eepyminded/openlab-drone/RAPORT/photo_meas_setup.png

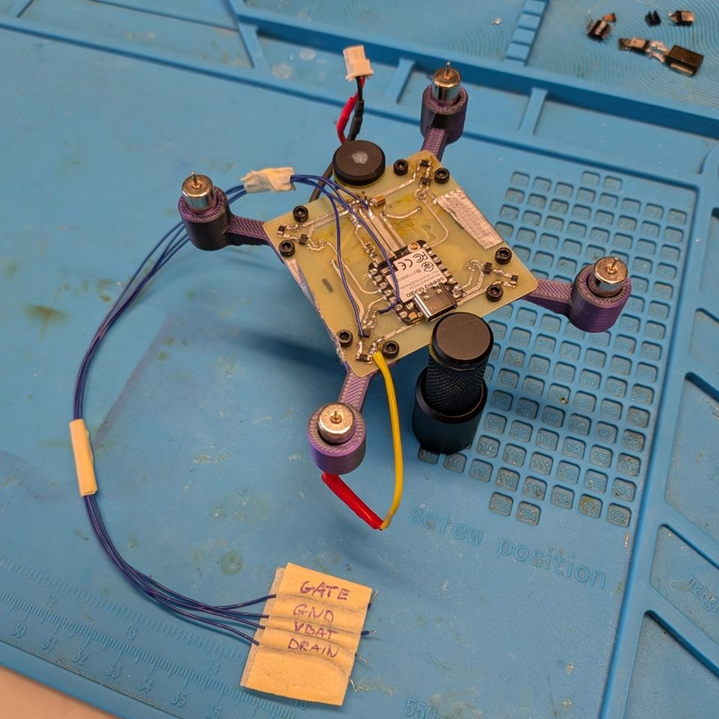
RAPORT/photo_meas_setup.png
