eepyminded/openlab-drone/RAPORT/photo_closeup_soldering.png

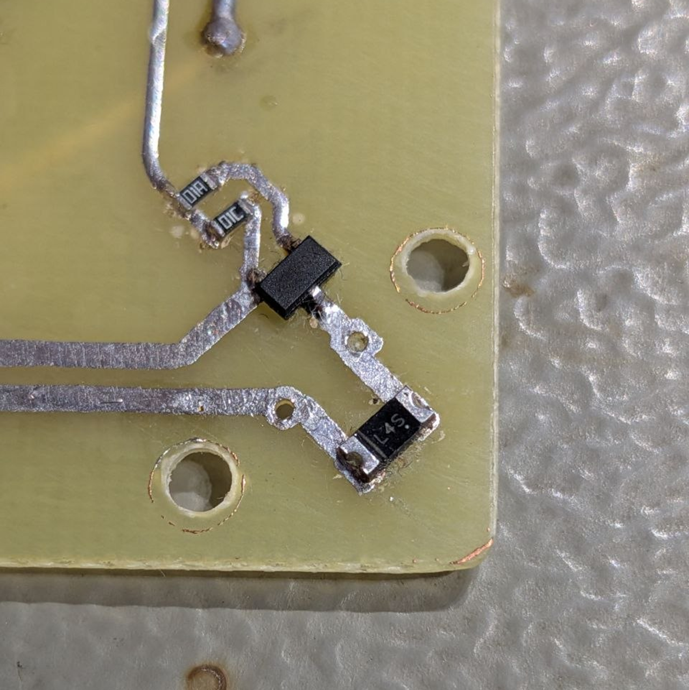
RAPORT/photo_closeup_soldering.png
