eepyminded/openlab-drone/media/Messenger_creation_0ABA836D-BF5E-4B1F-B3B8-3727AC7F190E.jpg

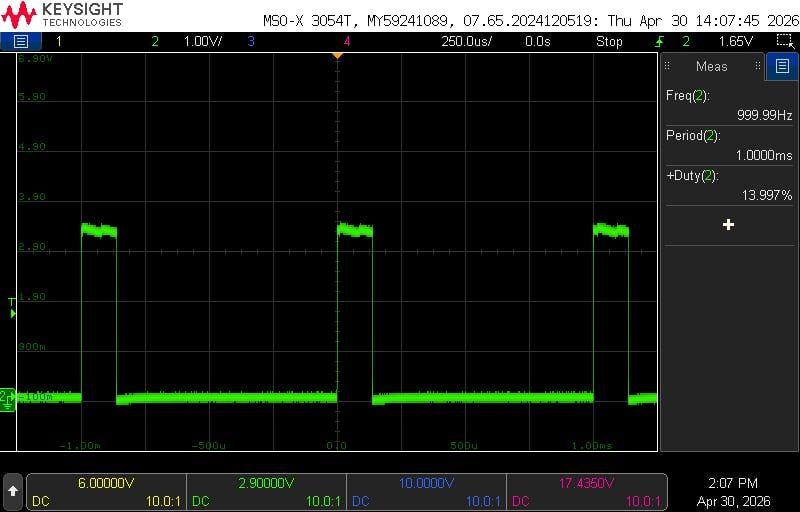
media/Messenger_creation_0ABA836D-BF5E-4B1F-B3B8-3727AC7F190E.jpg
