eepyminded/openlab-drone/media/scope_33.png

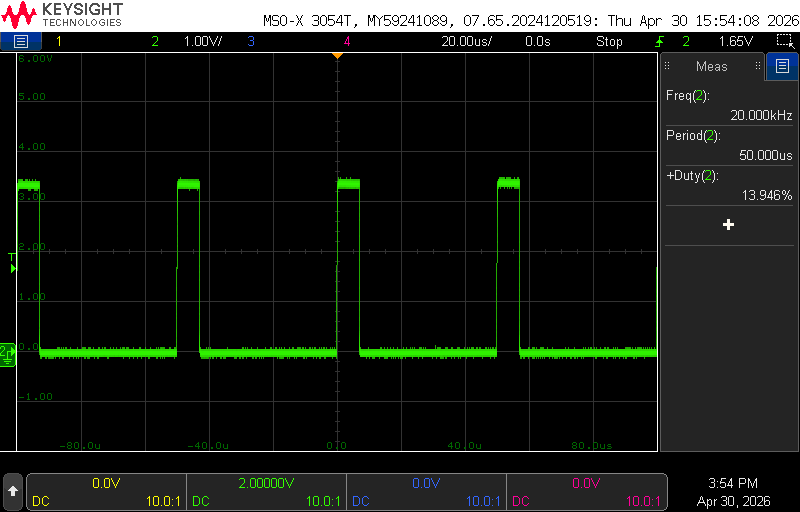
media/scope_33.png
