eepyminded/openlab-drone/media/scope_34.png

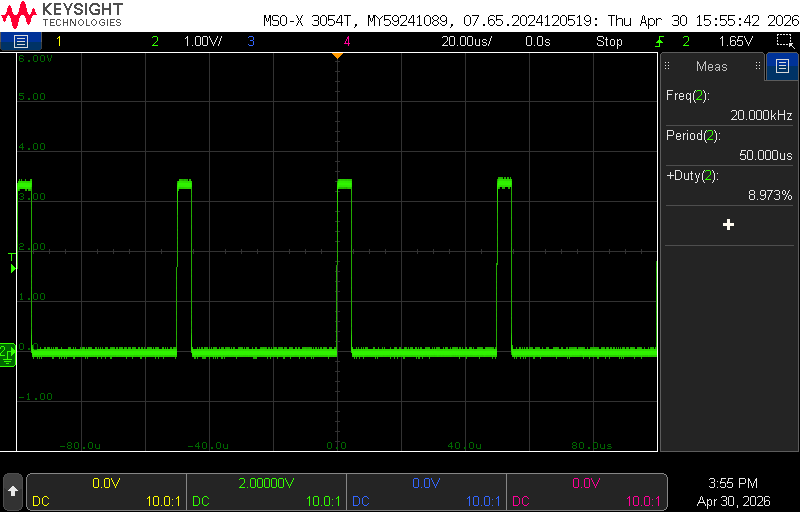
media/scope_34.png
