eepyminded/openlab-drone/media/scope_35.png

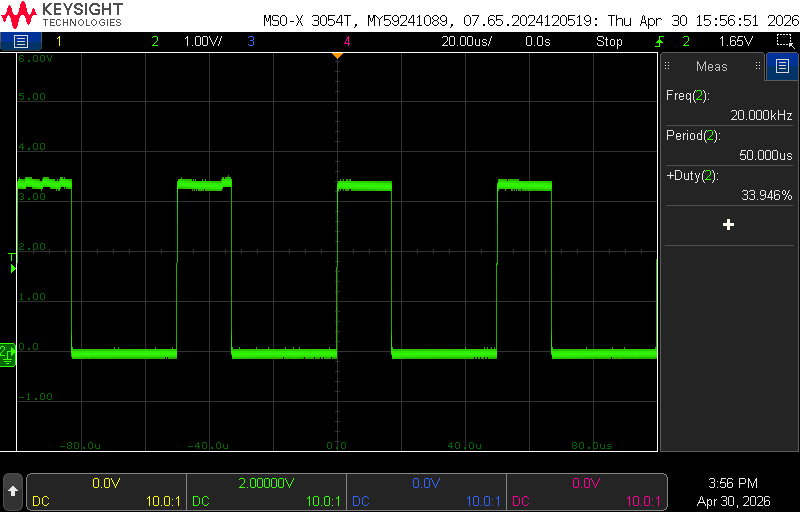
media/scope_35.png
