eepyminded/openlab-drone/RAPORT/meas_20us.png

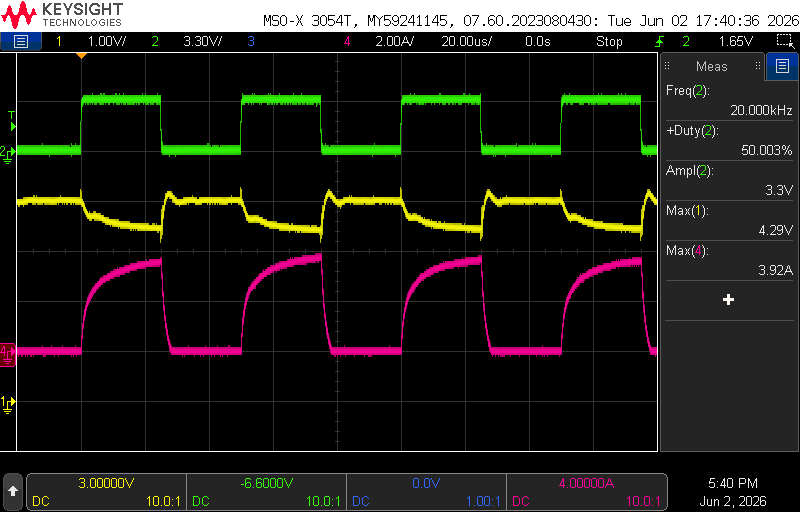
RAPORT/meas_20us.png
