eepyminded/openlab-drone/RAPORT/meas_100ns.png

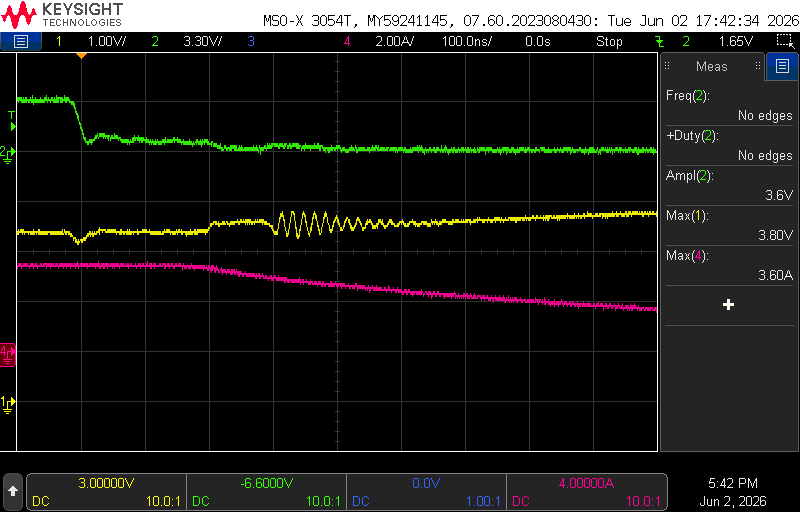
RAPORT/meas_100ns.png
