eepyminded/openlab-drone/RAPORT/meas_100ns_4u7.png

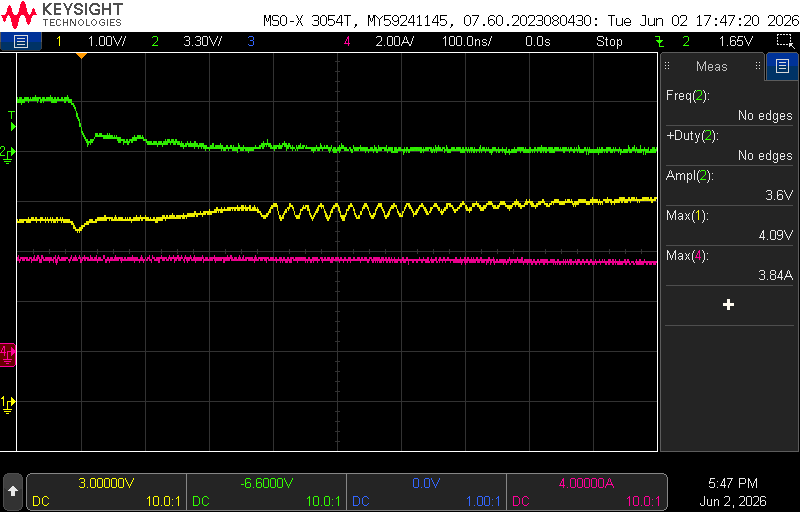
RAPORT/meas_100ns_4u7.png
