eepyminded/openlab-drone/RAPORT/render_drone.png

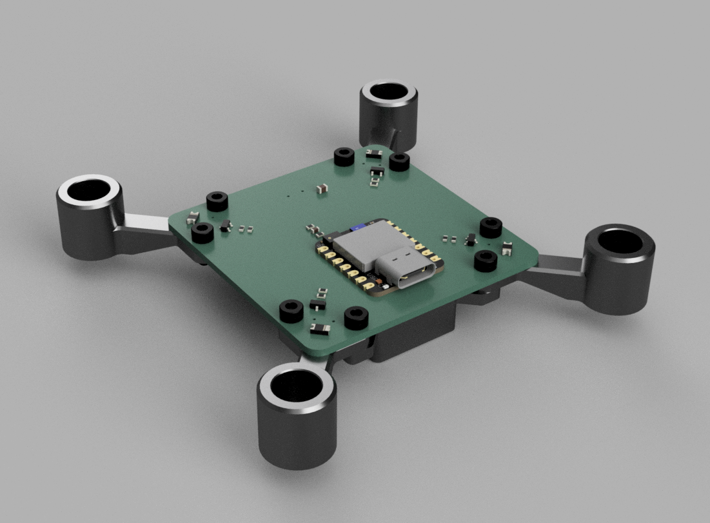
RAPORT/render_drone.png
