eepyminded/openlab-drone/RAPORT/schem_board-1.png

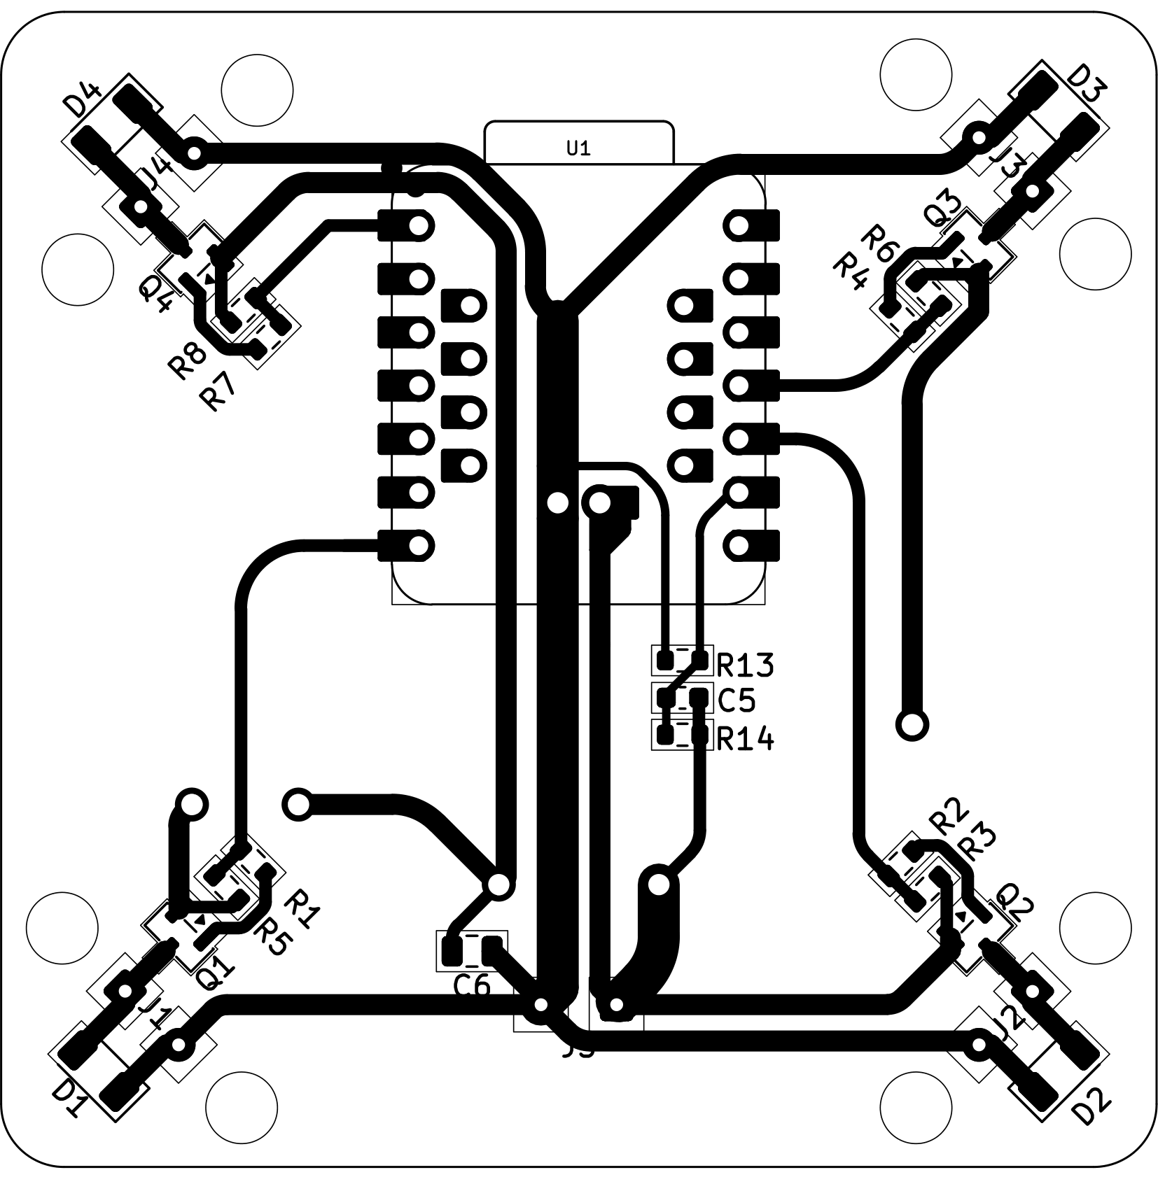
RAPORT/schem_board-1.png
