eepyminded/openlab-drone/RAPORT/schem_pcb-1.png

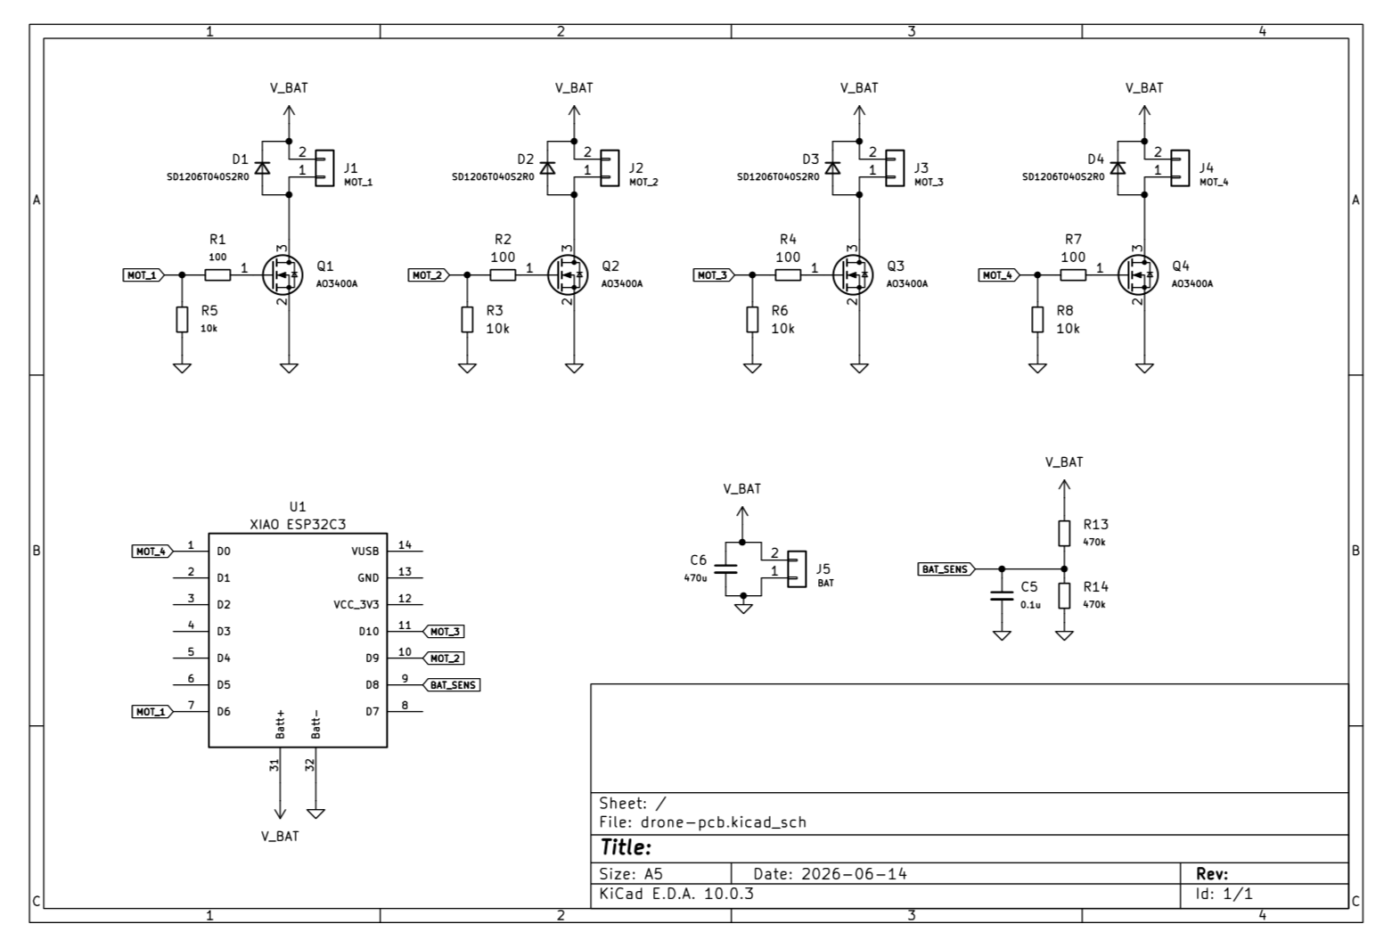
RAPORT/schem_pcb-1.png
