eepyminded/openlab-drone/RAPORT/spice_flyback_diode.png

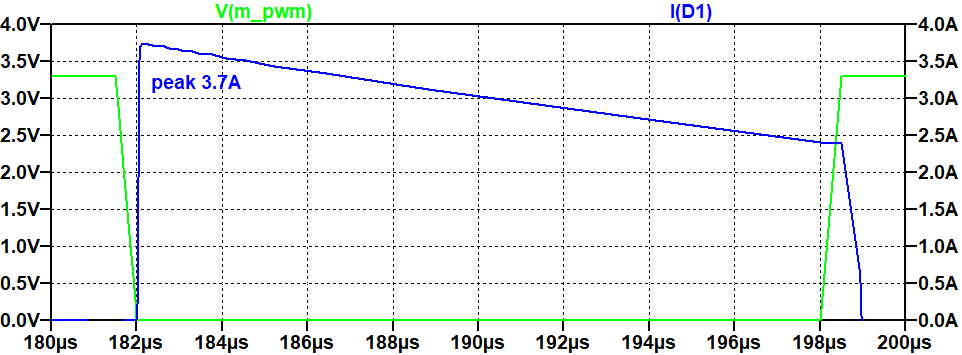
RAPORT/spice_flyback_diode.png
