eepyminded/openlab-drone/RAPORT/spice_r1_current.png

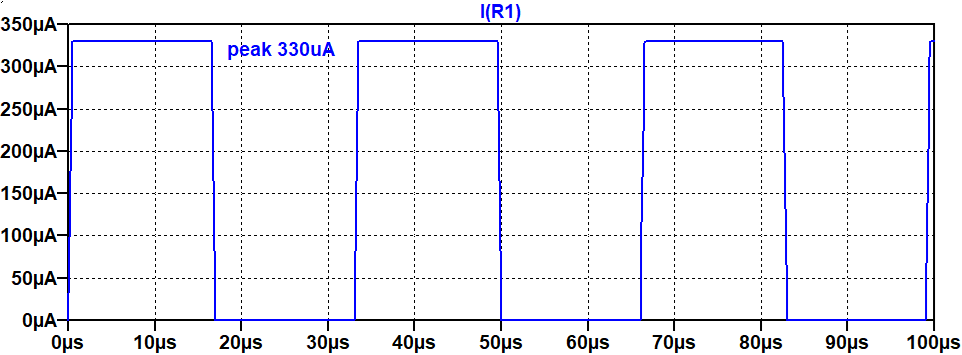
RAPORT/spice_r1_current.png
