eepyminded/openlab-drone/RAPORT/spice_r2_current.png

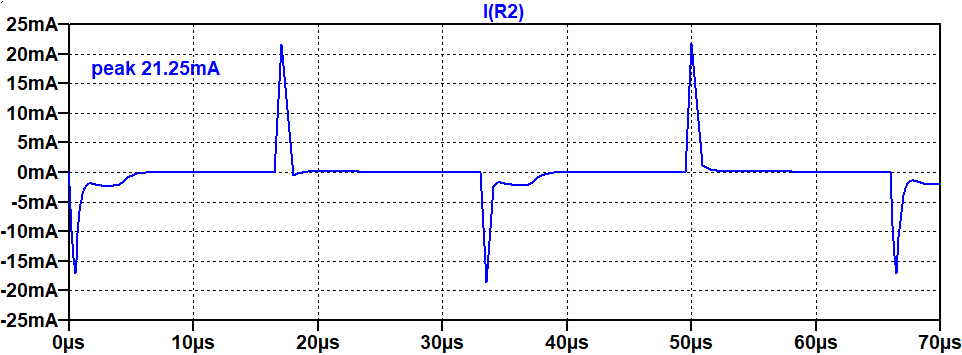
RAPORT/spice_r2_current.png
