eepyminded/openlab-drone/RAPORT/spice_schem.png

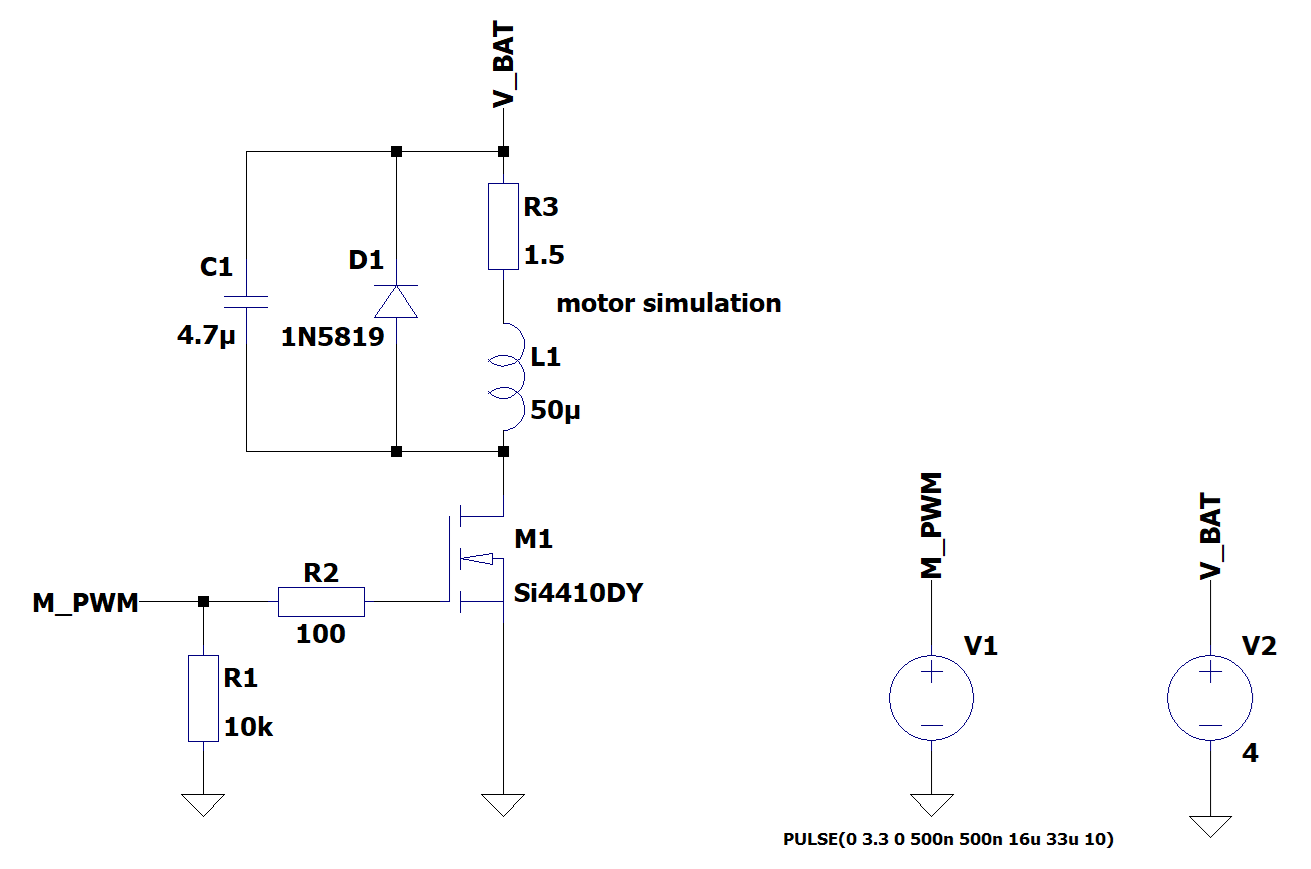
RAPORT/spice_schem.png
