eepyminded/openlab-drone/RAPORT/XIAO_MGM240S_KICAD_Prj-3.png

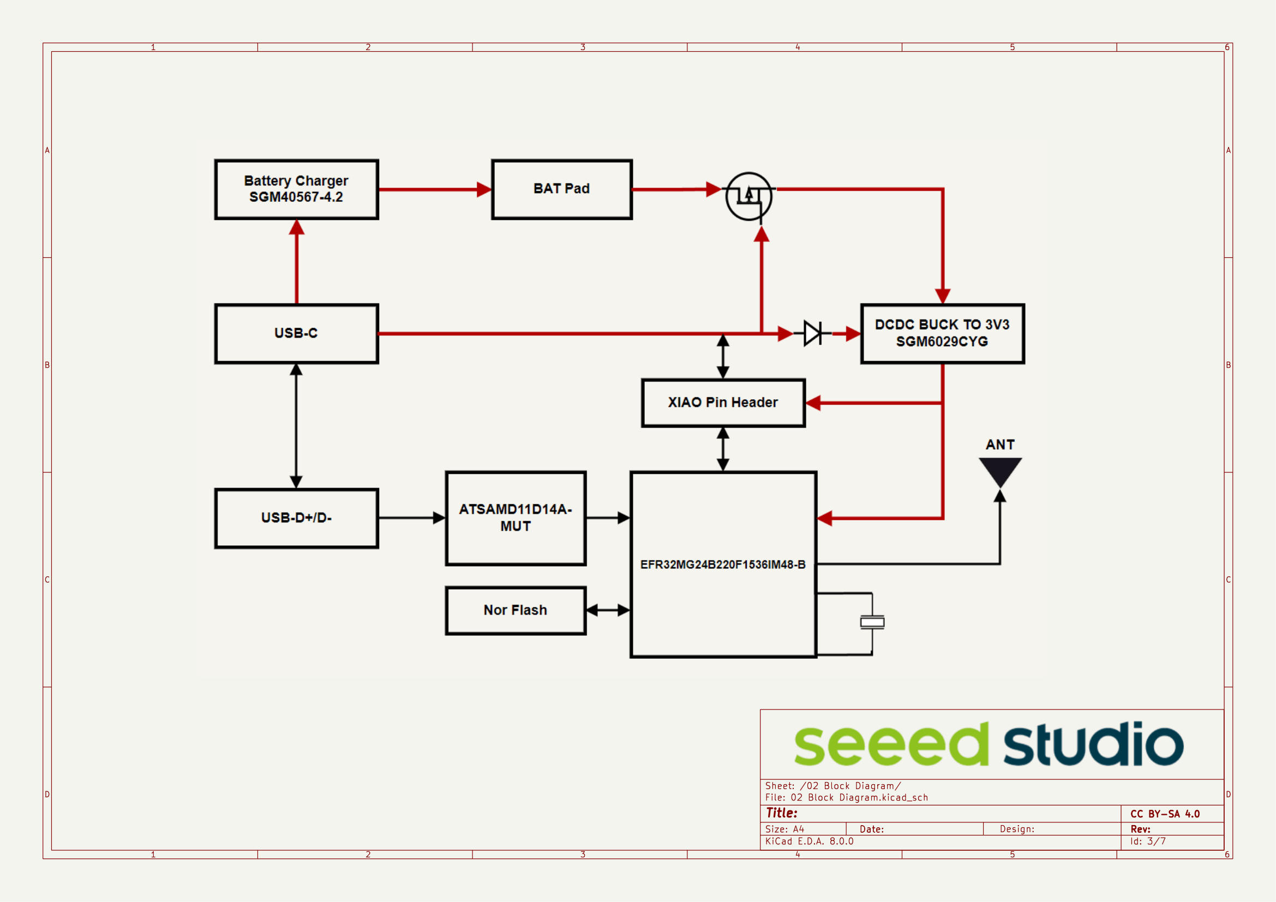
RAPORT/XIAO_MGM240S_KICAD_Prj-3.png
