eepyminded/openlab-drone/(list of files, cad)

Other CAD files:
drone.f3z
