eepyminded/openlab-drone/RAPORT/photo_printed_motor_housing.png

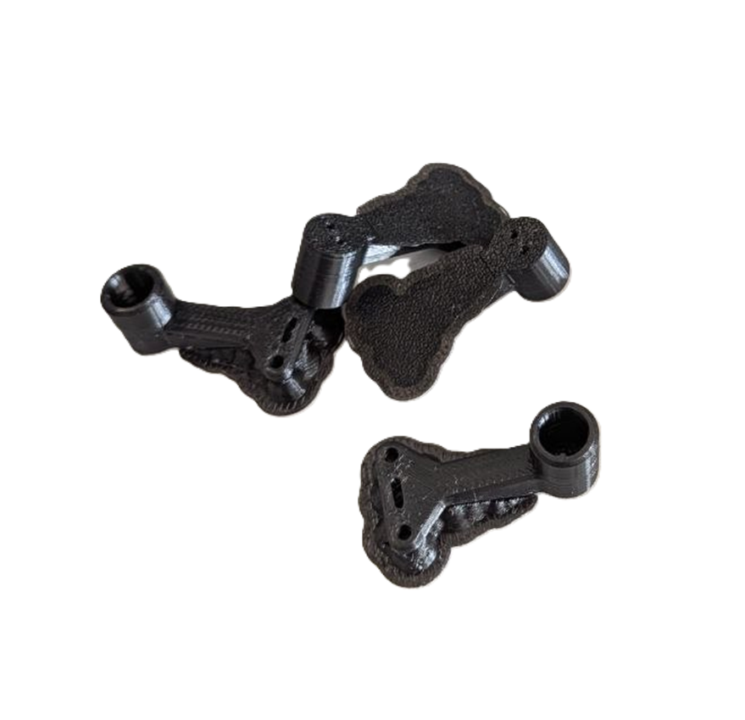
RAPORT/photo_printed_motor_housing.png
