eepyminded/openlab-drone/RAPORT/photo_soldered_pcb.png

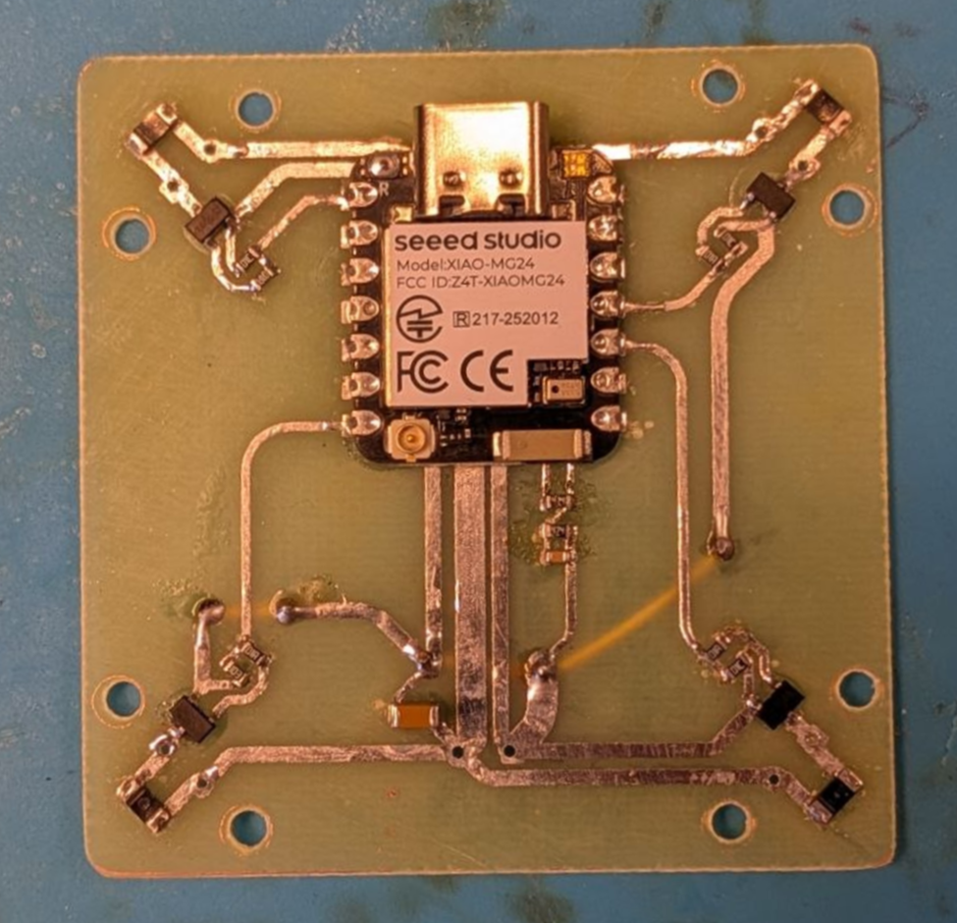
RAPORT/photo_soldered_pcb.png
