eepyminded/openlab-drone/RAPORT/schem_mechanical.pdf

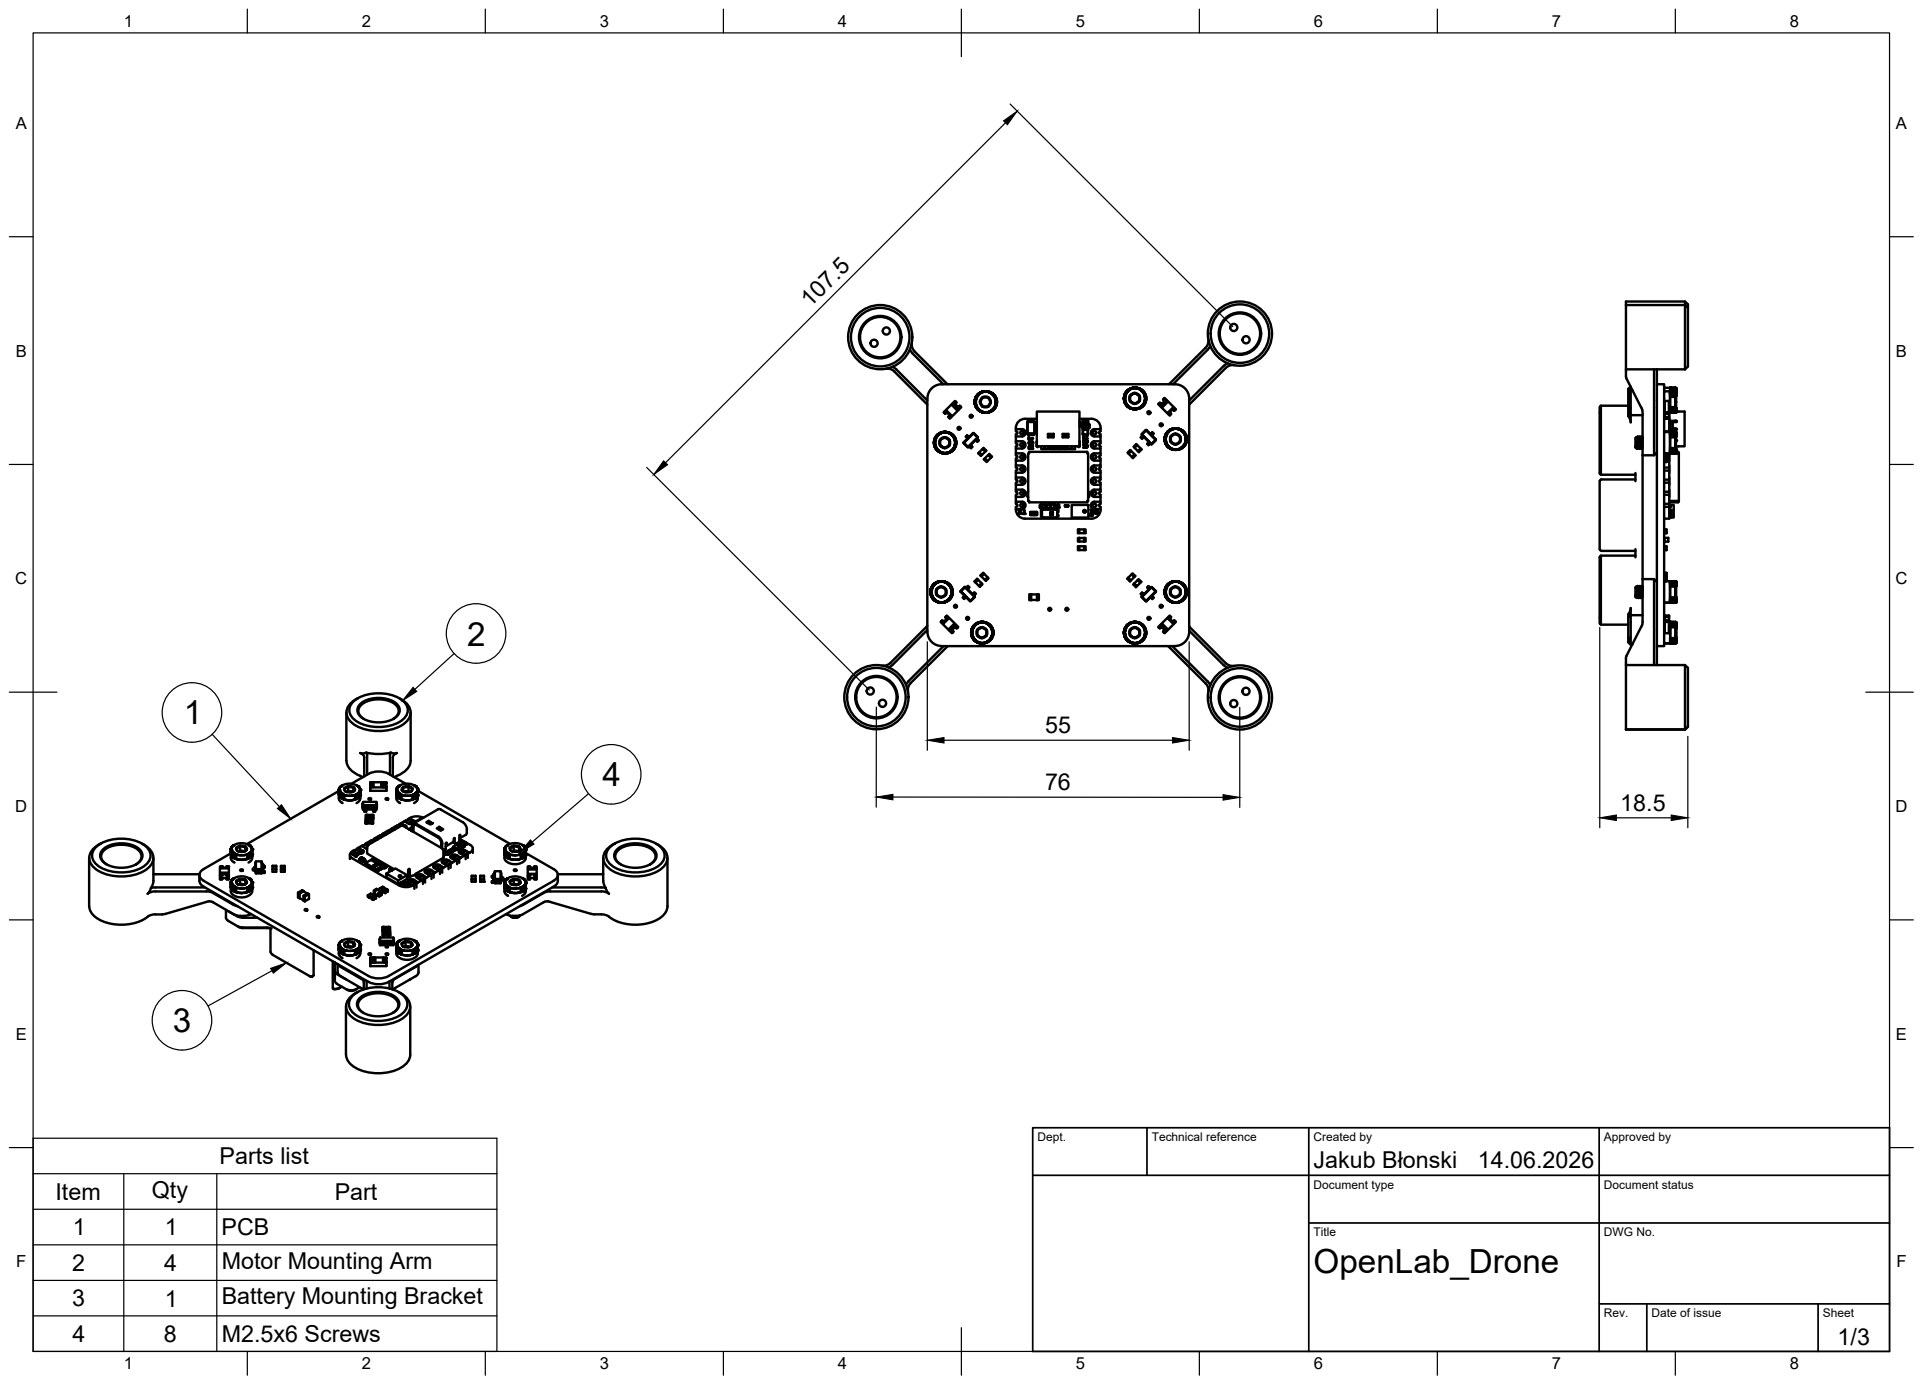
[picture p75: page 1]
Dept.; Technical reference; Created by; Approved by; Document type; Document status; Title; DWG No.; Rev.; Date of issue; Sheet; Jakub Błonski; Parts list; Motor Mounting Arm; Battery Mounting Bracket; M2.5x6 Screws

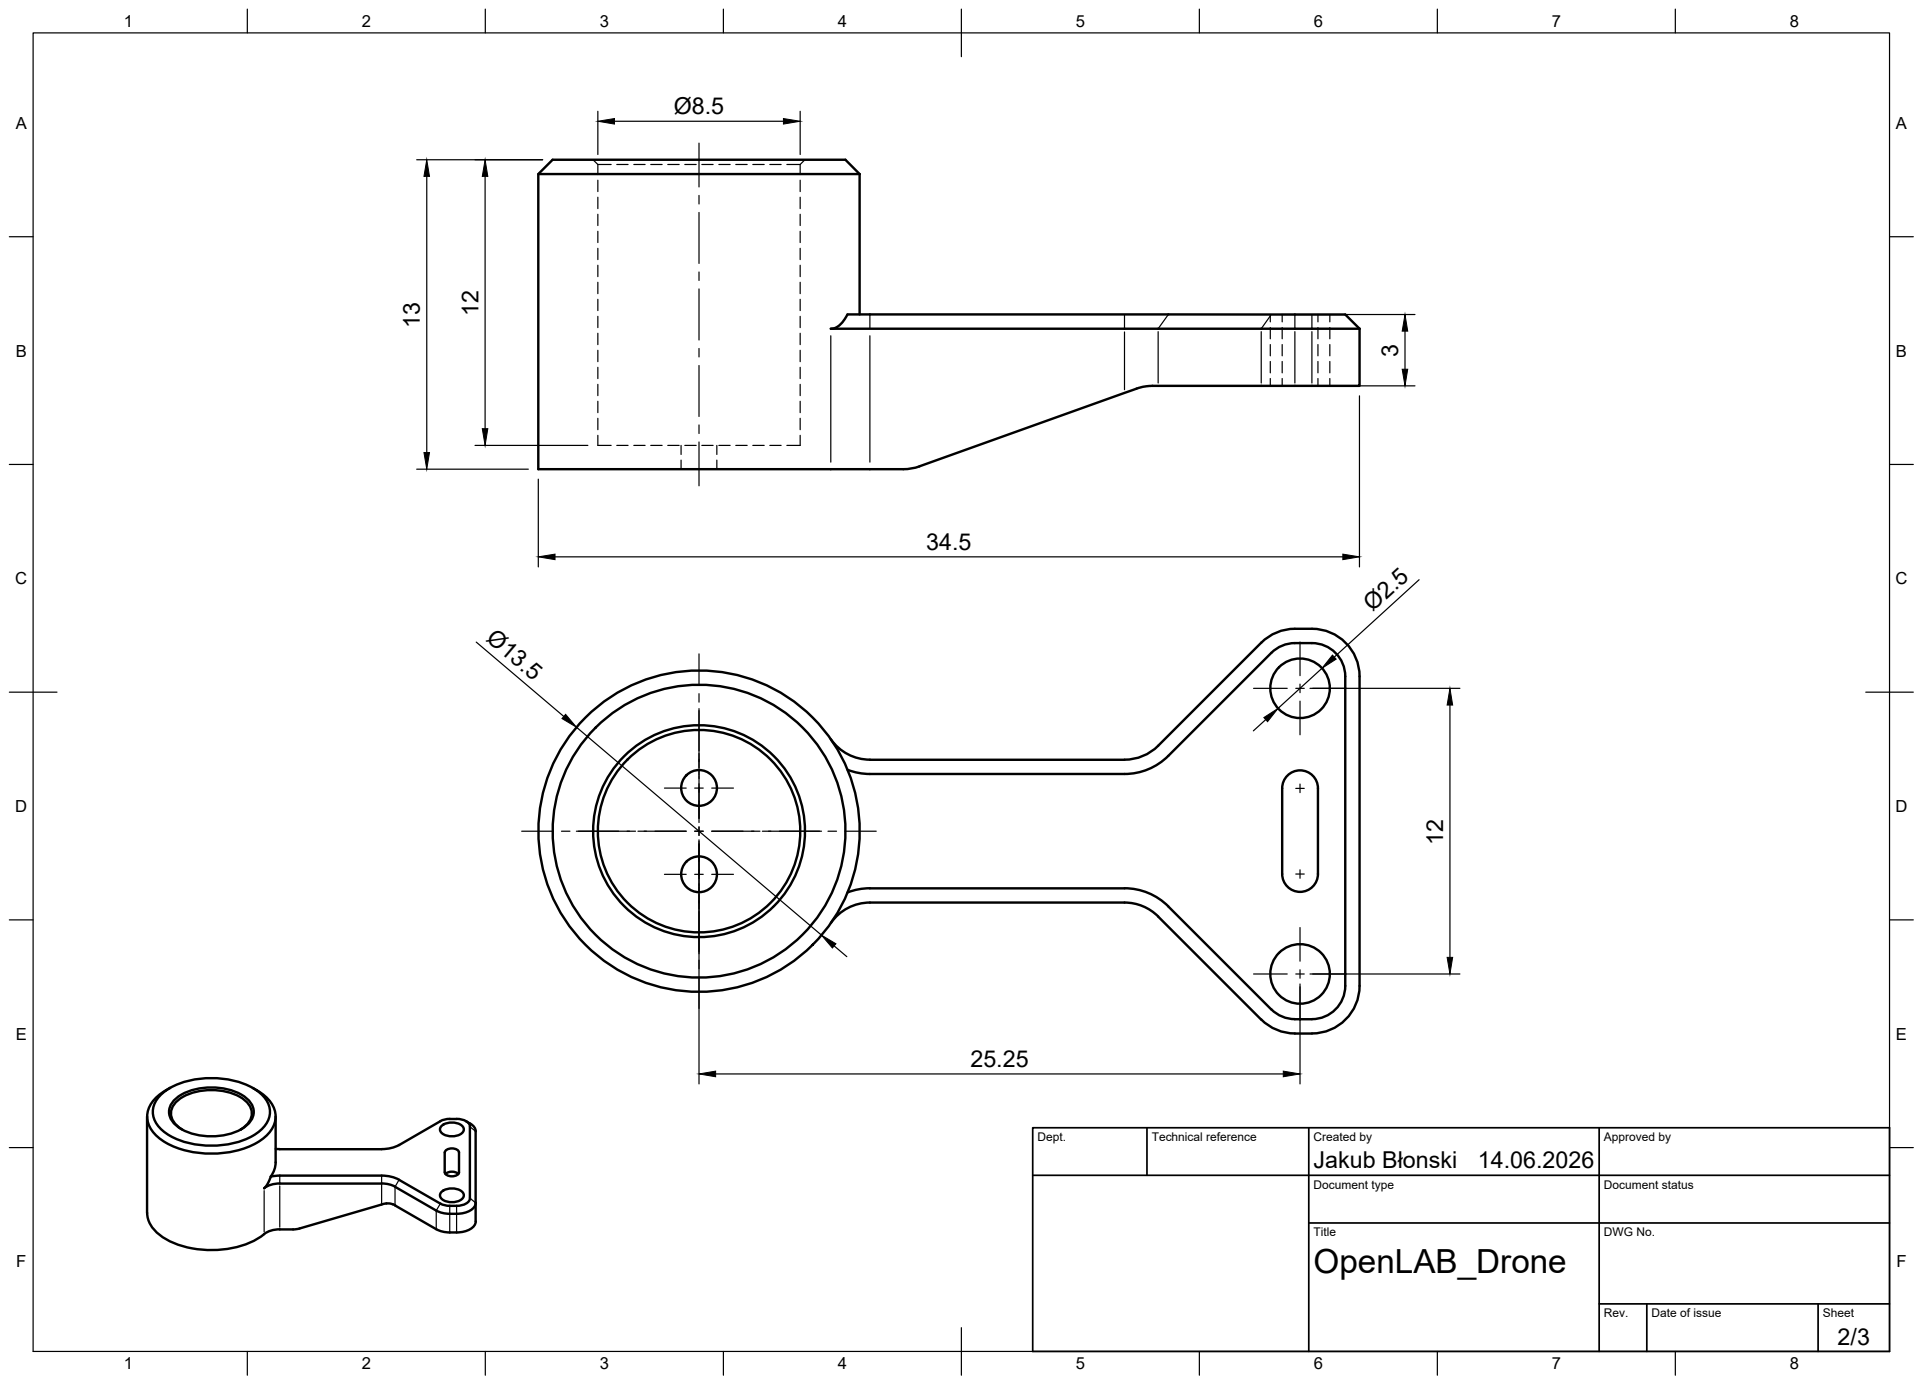
[picture p76: page 2]
Title; DWG No.

Dept. | Technical reference | Created by Jakub Błonski 14.06.2026 | Approved by

Document type | Document status

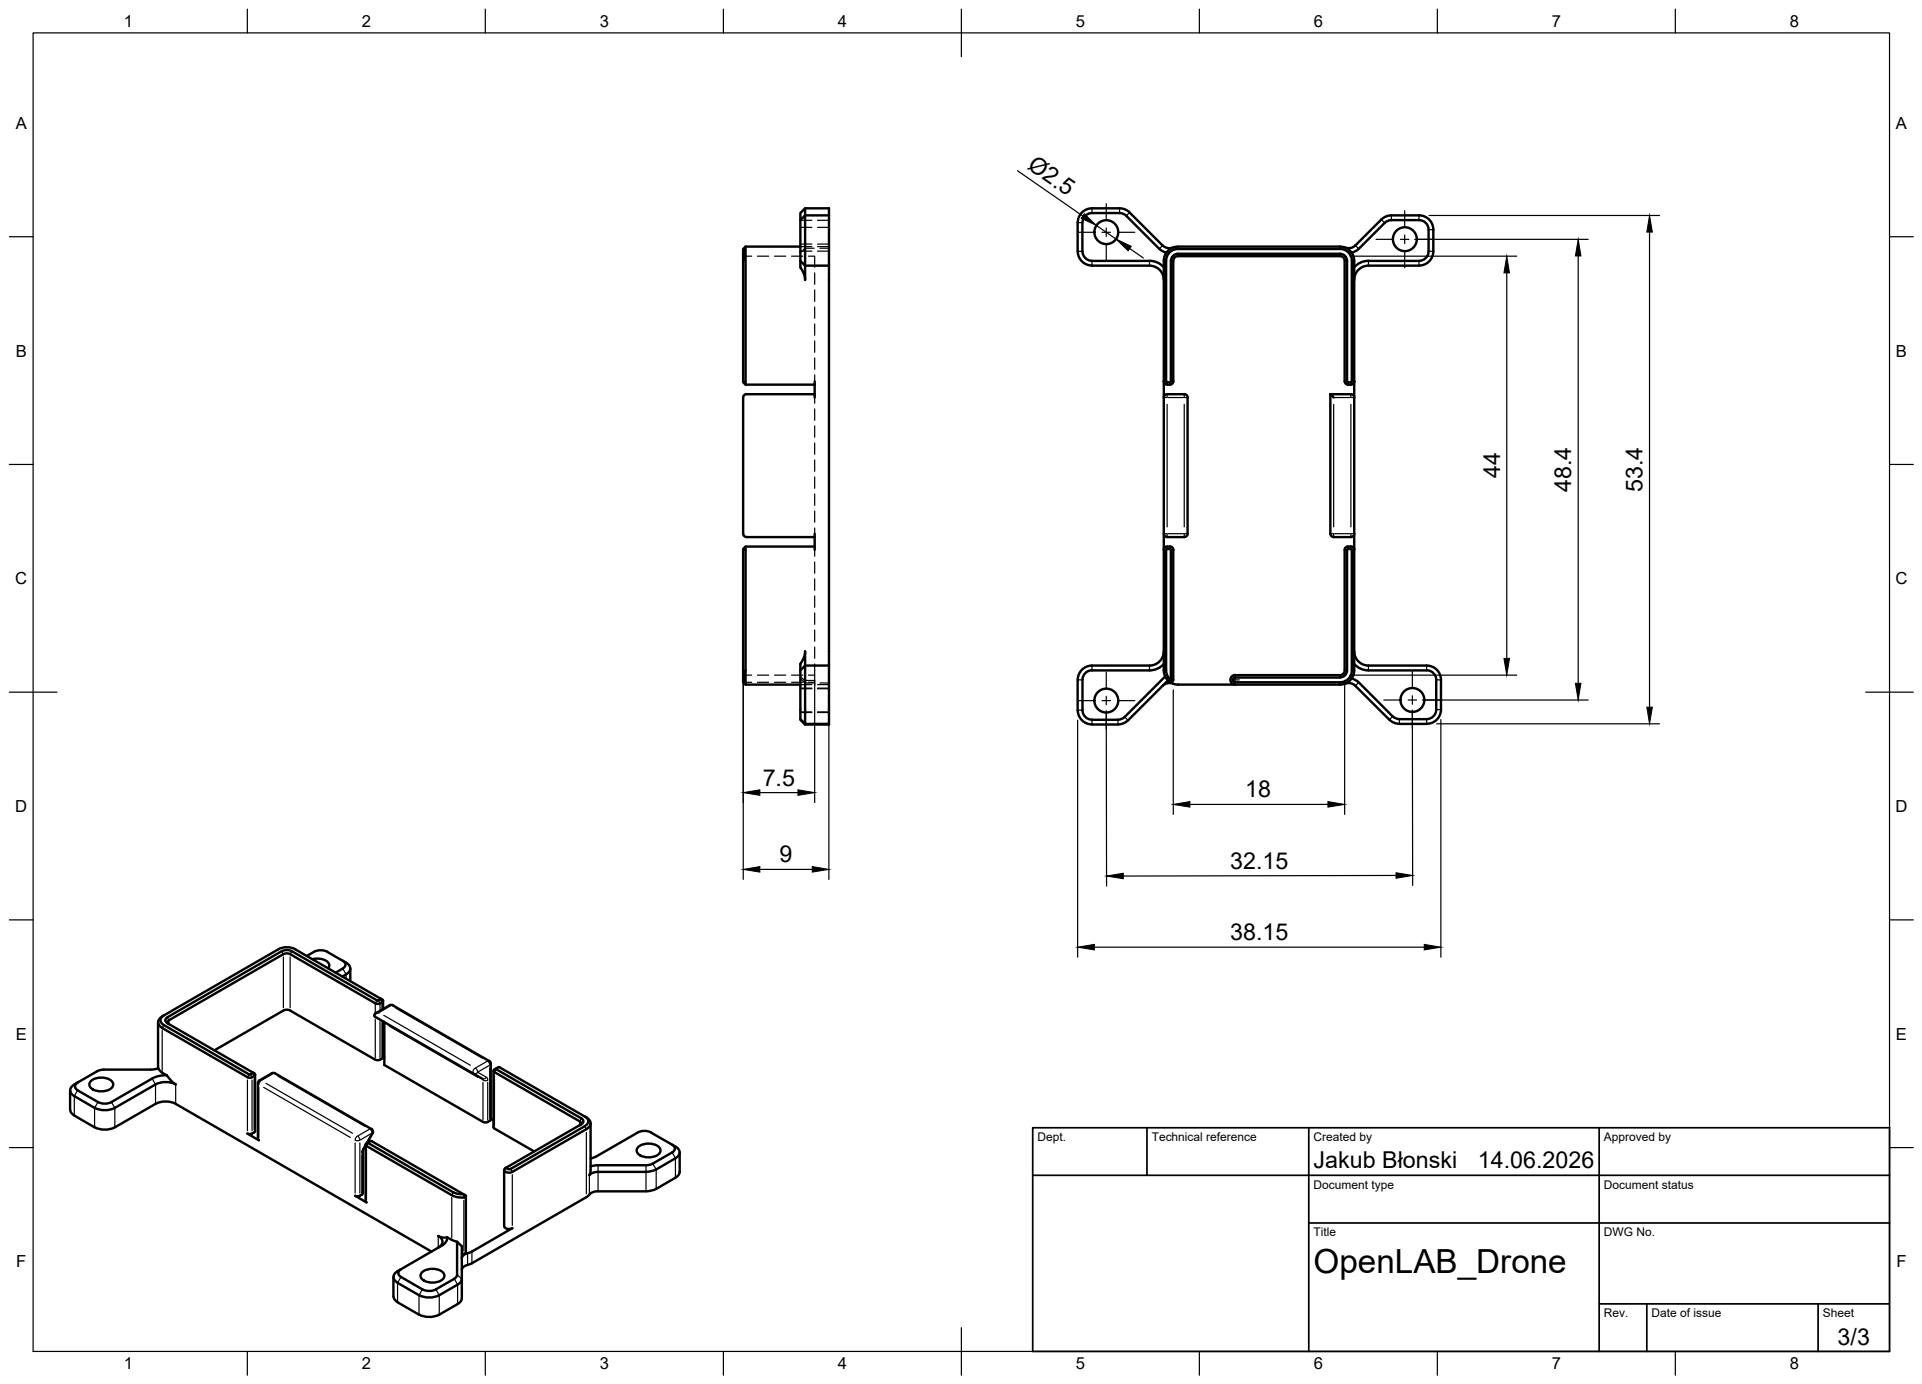
[picture p77: page 3]
Title; DWG No.

Dept. | Technical reference | Created by Jakub Błonski 14.06.2026 | Approved by

Document type | Document status
