eepyminded/openlab-drone/drone-pcb/plots/drone-pcb__Assembly.pdf

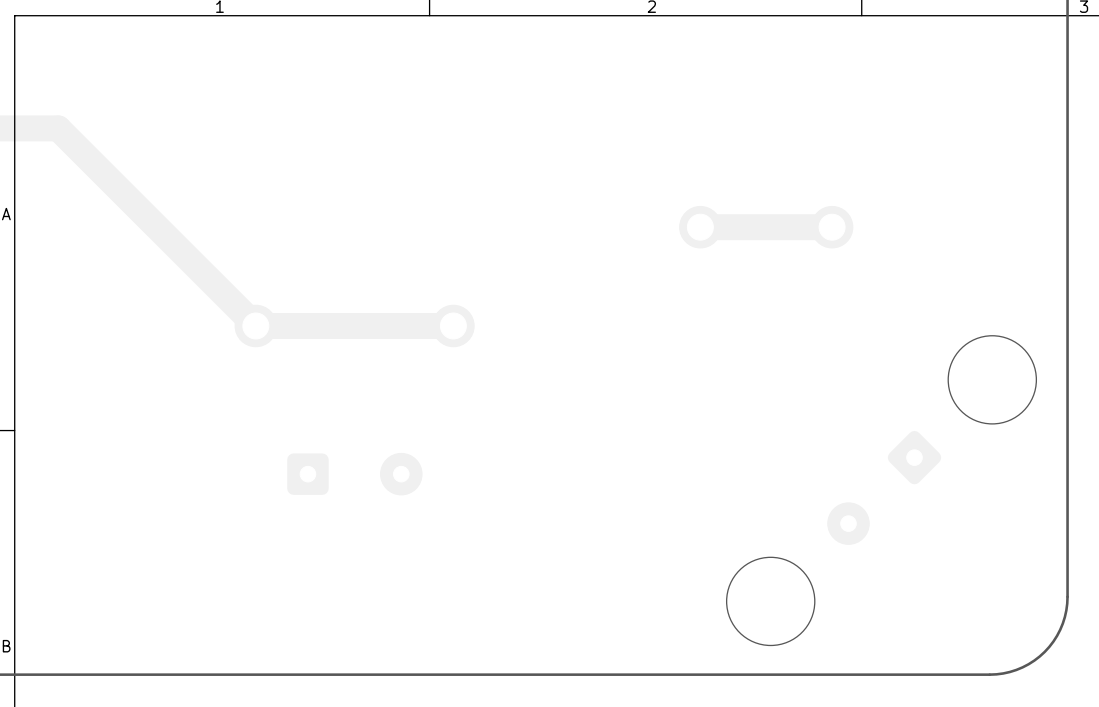
[picture p78: page 1]
D Date:; Size: A4; Rev:

Board2Pdf: Black And White TOP - Page 1/2

Sheet: Black And White TOP
File: drone-pcb.kicad_pcb
Title:
KiCad E.D.A. 10.0.3

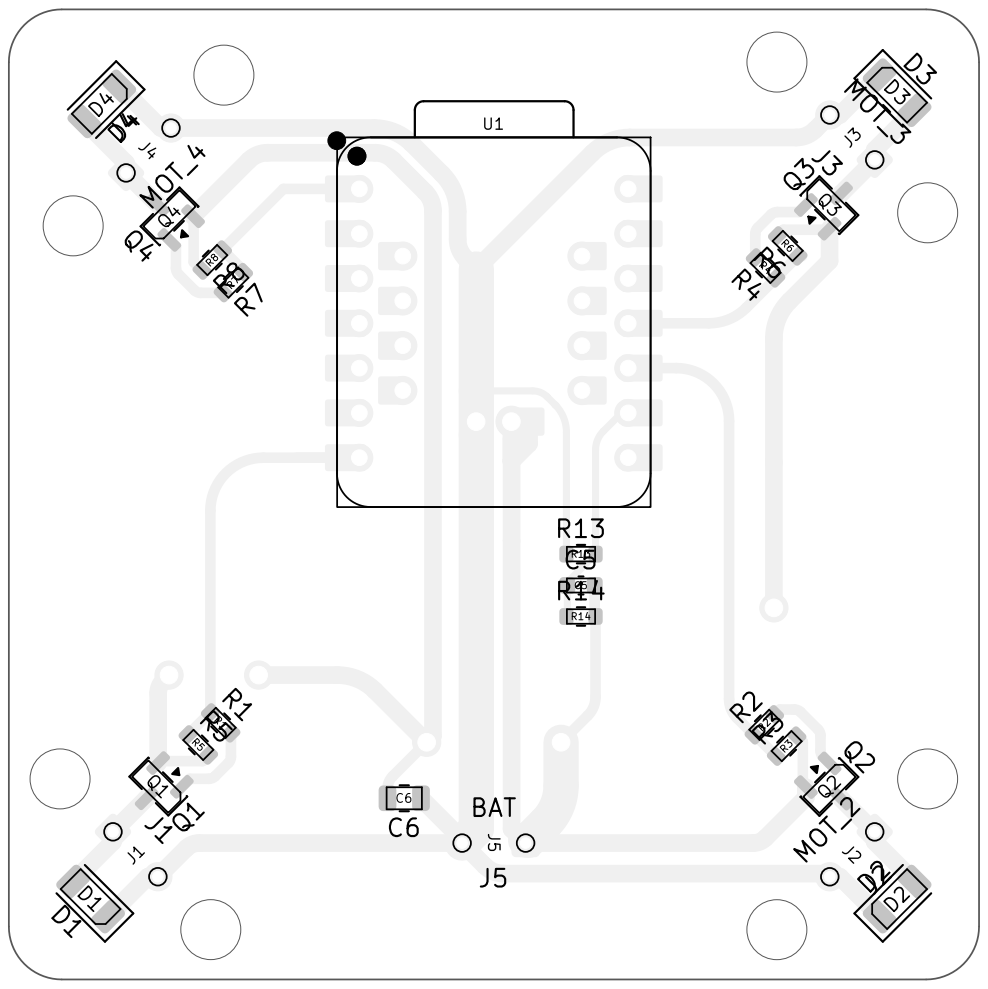
[picture p79: page 2]

Board2Pdf: Black And White BOT - Page 2/2

Sheet: Black And White BOT
File: drone-pcb.kicad_pcb
Title:
KiCad E.D.A. 10.0.3
