eepyminded/openlab-drone/RAPORT/schem_board.pdf

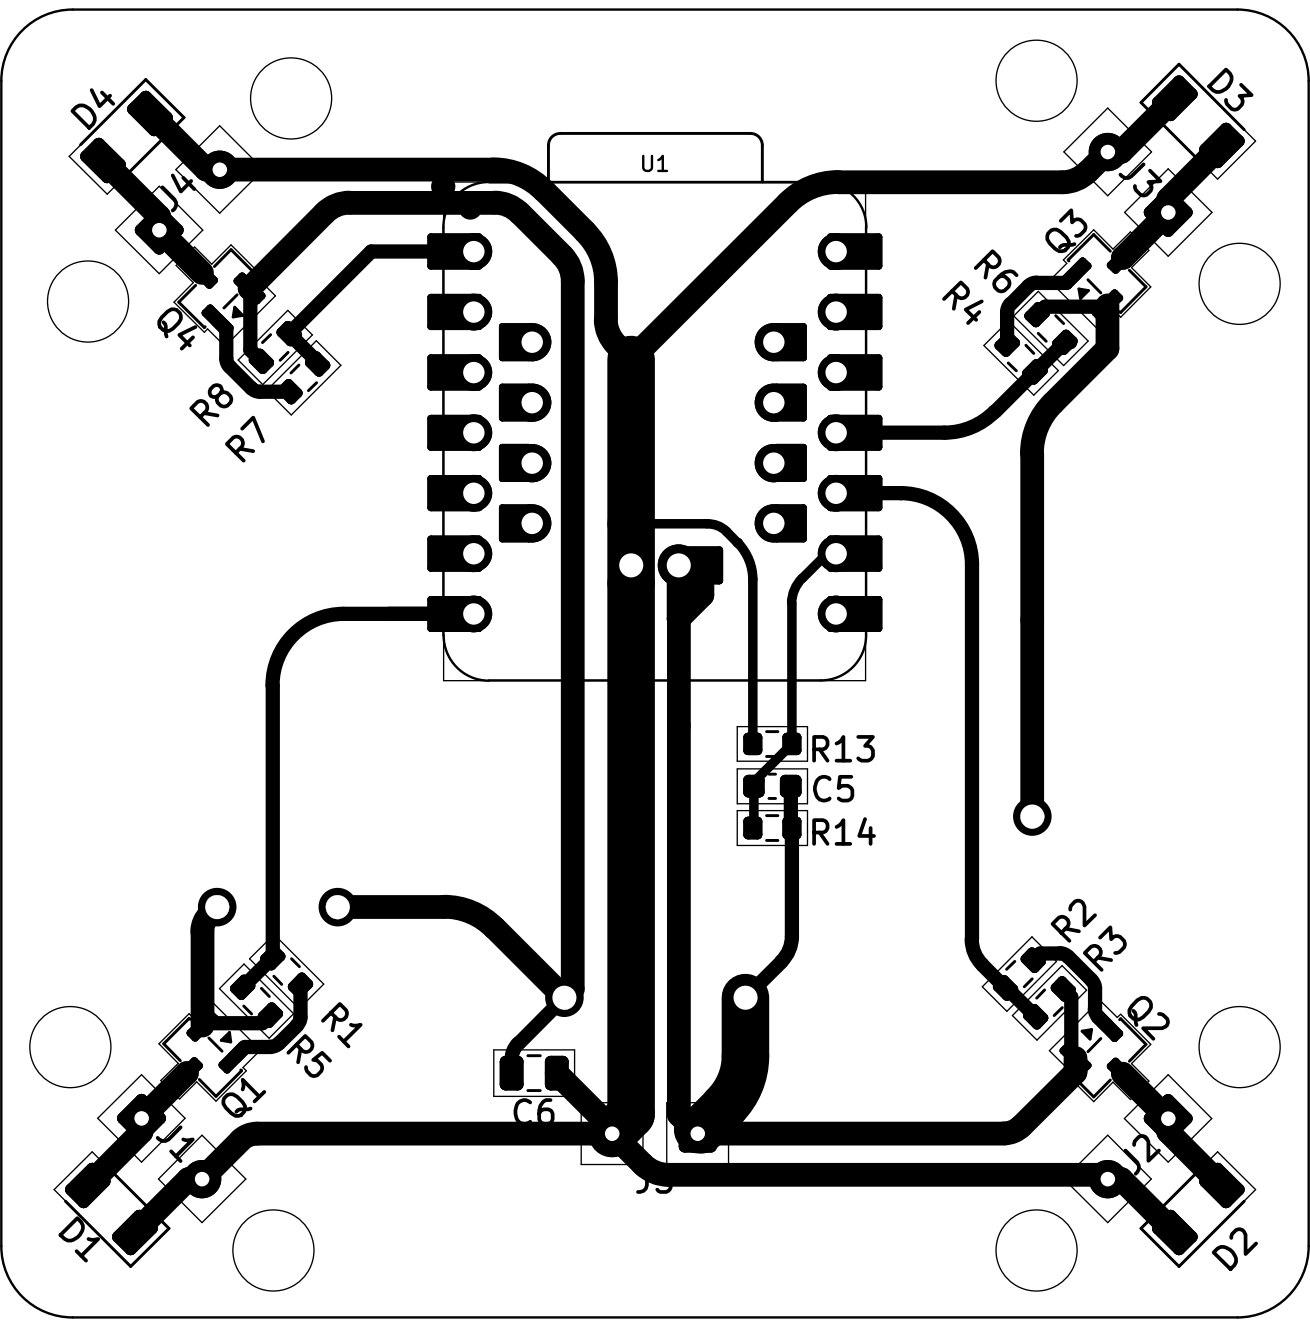
[picture p80: page 1]
