eepyminded/openlab-drone/RAPORT/schem_pcb.pdf

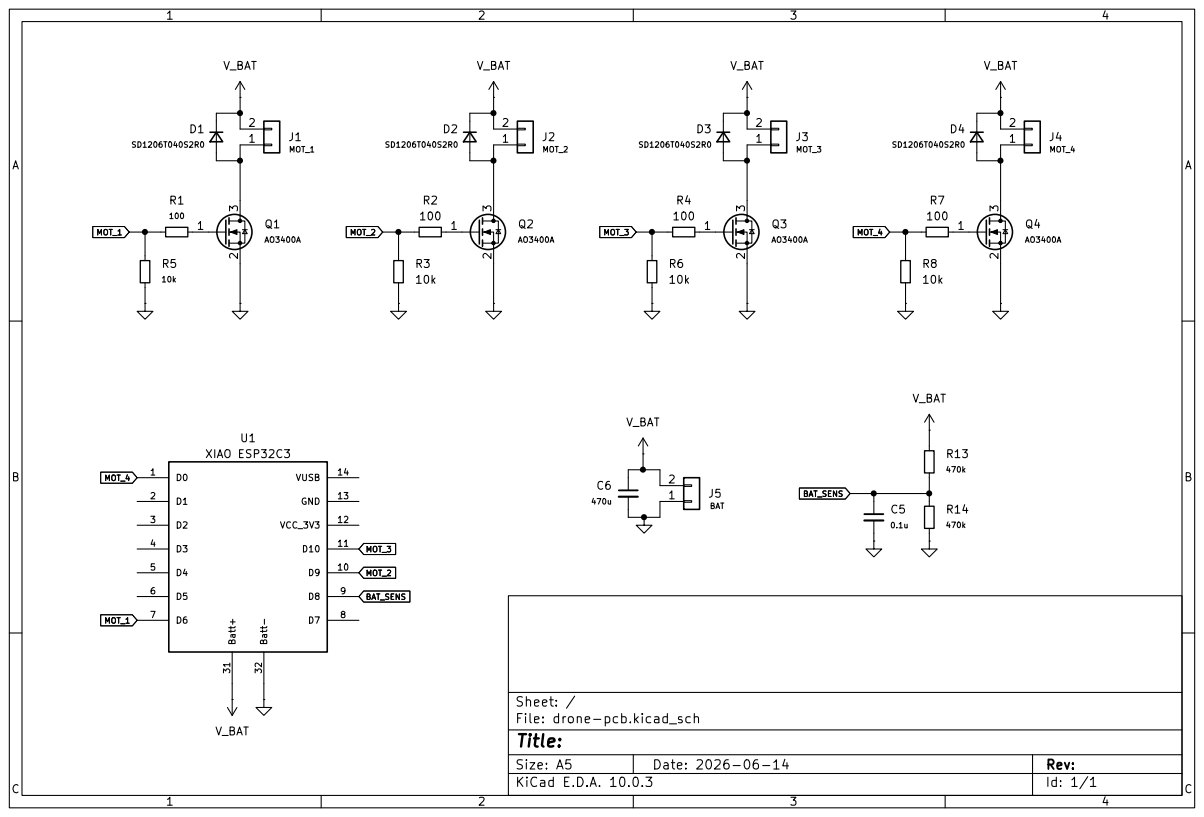
[picture p81: page 1]
