eepyminded/openlab-drone/drone-pcb/drone-fab.pdf

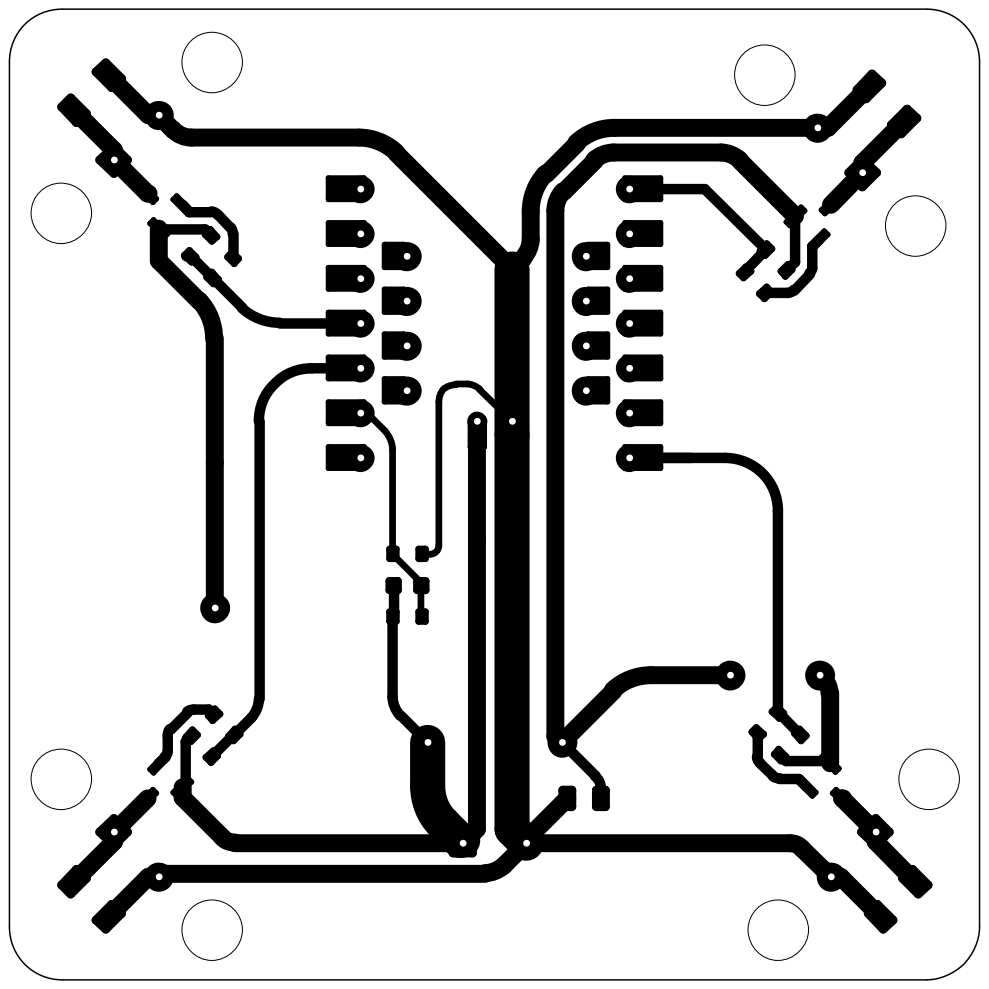
[picture p82: page 1]
