eepyminded/openlab-drone/LTSpice-schematics/pwm_shenanigans.asc

D1: diode; SD1206T040S2R0
L1: ind; 20µ; Rser=1m
L2: ind; 50n; Rser=1m
L3: ind; 50n; Rser=1m
M1: nmos; AP9465GEM
R1: EuropeanResistor; 10k
R2: EuropeanResistor; 100
R3: EuropeanResistor; 2.1
V1: voltage; PULSE(0 3.3 0 500n 500n 16u 33u 10)
V2: voltage; 4
Named nets: 0, M_PWM, V_BAT
.include AO3400.mod
.tran 0 100u 0 10u
motor simulation
.model SD1206T040S2R0 D(Is=50u Rs=0.08 N=1.05 Cjo=115p Bv=40 Ibv=1m Eg=0.69)
