eepyminded/openlab-drone/(commit log)

2026-03-21 ltspice schematic file upload
2026-03-23 reareanged the cables and compontents, so its more readable
2026-03-29 created draft schematic
    [drone-pcb.kicad_pcb, drone-pcb.kicad_sch, spice-copy.kicad_sch]
2026-03-30 add footprints
2026-03-30 draft pcb layout
    [drone-pcb.kicad_pcb, drone-pcb.kicad_sch]
2026-03-30 changed the efficiency calculations, added a description for transistor power dissipation
2026-04-14 pcb design, ground, vcc to be changed yet
    [drone-pcb.kicad_pcb, drone-pcb.kicad_sch]
2026-04-18 apdejt rev 2
    [drone-pcb.kicad_pcb, drone-pcb.kicad_sch]
2026-04-20 rev 2 apdejt
    [drone-pcb.kicad_pcb, drone-pcb.kicad_sch]
2026-05-15 pwm testy
2026-06-01 initial unpolished arduino drone code upload + library edits
